Gentlesprite/STBU_Foolish_Potted_Plant/资料/IMG_1619.JPG

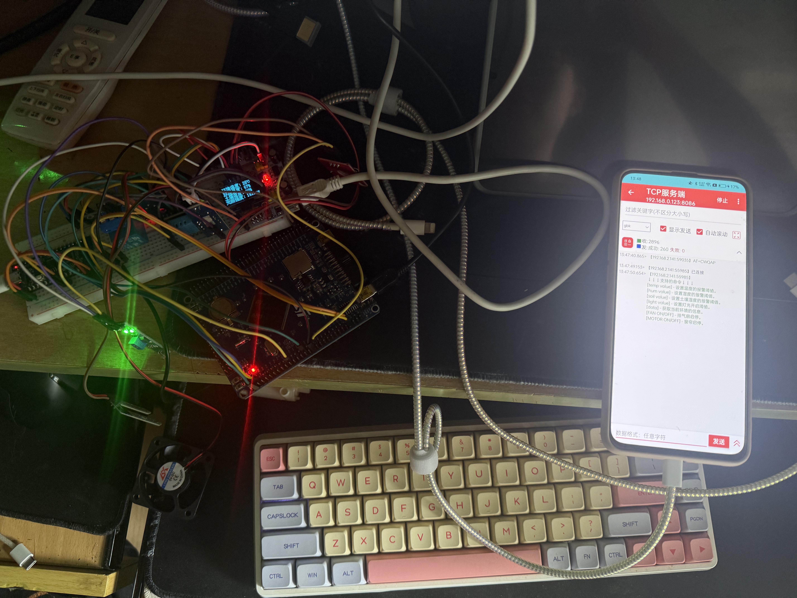
资料/IMG_1619.JPG
