Gentlesprite/STBU_Foolish_Potted_Plant/资料/个人总结.docx

四、总结

4.1 本人负责的工作内容概述

在本项目中，我负责以下模块的设计与实现：HW-080土壤湿度传感器、JY30光照强度传感器、HW-269LED模块、DHT11温湿度传感器驱动，SSD1306显示模块驱动、阈值报警、UART1、UART2、UART3通信。串口通信与命令解析：配置STM32串口3空闲中断，实现不定长数据接收、解析TCP客户端中用户发送的指令，实现阈值设定及设备控制。在论文撰写方面负责：设计任务、设计要求、设计思路及方案的撰写，同时负责硬件原理图、程序流程图的绘制。

4.2 本人负责的关键技术实现

4.2.1 传感器数据采集与处理

(1) JY30光照强度传感器：使用I2C协议通信，获取光照数据, 模拟电压采集，ADC转换。ADC转换参数是12位分辨率（0-4095），55.5个周期采样时间，参考电压3.3V。数据转换公式：电压值 = (ADC值/4096) * 3.3V。计算LDR电阻：R = (电压/(3.3-电压)) * 10kΩ。照度转换：Lux = 40000 * R^(-0.6021)。输出限制：最大值限定为999 Lux。

(2) HW-269LED模块：使用电平触发方式，在环境光照过低时，用于补光功能。GPIO直接驱动，推挽输出控制。高电平触发，初始化使能APB2总线GPIOB时钟，初始化后拉低PB1让灯光熄灭。

(3) DHT11温湿度传感器：使用单总线协议通信，严格时序控制（微秒级延时）数据校验机制：校验和=湿度高8位+湿度低+温度高8位+温度低8位。

4.2.2 OLED显示模块

使用I2C协议通信，SDA：数据线（双向开漏，需上拉电阻），SCL：时钟线（单向，需上拉电阻），起始条件：SCL高电平时，SDA由高→低跳变。数据传输：每1bit在SCL上升沿被采样，下降沿切换SDA。地址帧：7位设备地址（0x78或0x7A）+ 读写位（0=写，1=读）。停止条件：SCL高电平时，SDA由低→高跳变。驱动OLED将温湿度、土壤湿度、光照强度实时显示。

4.2.3 串口通信与命令解析

(1) 串口空闲中断配置

初始化USART3（PB10/PB11），开启空闲中断（IDLE）接收不定长数据，避免固定长度缓冲区的限制，空闲中断实现命令解析与执行。设计的命令如下表：

命令 | 意义
temp value | 设置环境温度的报警阈值
hum value | 设置环境湿度的报警阈值
soil value | 设置土壤湿度的报警阈值
light value | 设置灯光开启阈值
data | 获取当前环境的信息
FAN ON/OFF | 排气扇启停
MOTOR ON/OFF | 水泵启停
LED ON/OFF | LED启停
未知命令的处理 | 发送支持的命令提示

## 表4 项目支持的命令表

4.3 遇到的问题及解决方案

4.3.1 问题1

问题：使用STM32通过AT指令配置ESP32为STA模式，连接手机TCP服务器后，调用esp_32c3_send_data函数向APP发送数据时，数据被错误发送到串口1而非预期的串口3。

原因：ESP32 状态混乱：ESP32 可能处于某种异常状态（如未正确退出透传模式、TCP 连接未正常关闭），导致后续数据发送混乱。串口缓冲区未清空：如果 USART1 和 USART3 的缓冲区未正确清理，可能导致数据被错误地发送到错误的串口。AT 指令执行顺序问题：某些 AT 指令（如 AT+CIPMODE 透传模式）可能会影响 ESP32 的数据流控制，导致串口数据异常。

解决：在主函数调用esp32初始化后调用esp_32c3_send_cmd("AT+CWQAP","OK",200);先主动断开与手机热点的连接，然后再正常连接WiFi，退出透传再进入透传即可解决该问题。

4.3.2 问题2

问题：APP发送命令STM32只能收到一个字符。

原因：串口中断一次只能接受一个字符，导致发送一串字符时命令无法解析。

解决：在初始化中断3时启用空闲中断(USART_IT_IDLE)。

4.3 总结与收获

通过本次项目，我深入掌握了多传感器数据采集与处理：ADC、UART、单总线协议的应用、空闲中断的实际应用场景、开发了基于串口的用户命令解析系统，支持多种控制指令。熟练嵌入式系统人机交互：OLED显示驱动并且通过取模软件自制字库显示汉字。通信协议设计：学会了使用空闲中断来接收一段字符与串口命令解析，实现发送命令的方式配合ESP32C3远程控制设备。调试与优化能力：在本项目中本人采用Git版本控制工具进行清晰有条的版本控制。这次项目不仅巩固了我的嵌入式开发技能，更让我深刻体会到了无线通信技术在智能、自动化管理等领域中的不可或缺地位。同时培养了我解决复杂工程问题的能力，通过团队分工交流合作不断迭代，经历了完整的开发迭代流程，从设计任务要求到功能优化，调试代码，不断解决制作过程中所遇到的各种问题，在完成了课程设计的同时也积累了宝贵的项目经验。

改进方向：可引入更高效的数据压缩算法，减少WiFi传输数据量。增加本地存储功能（EEPROM），保存并记忆用户设定的阈值。
