Gentlesprite/STBU_Foolish_Potted_Plant/资料/LED模块.png

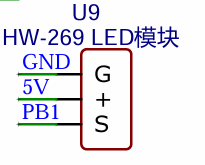
资料/LED模块.png
