Gentlesprite/STBU_Foolish_Potted_Plant/资料/WIFI模块.png

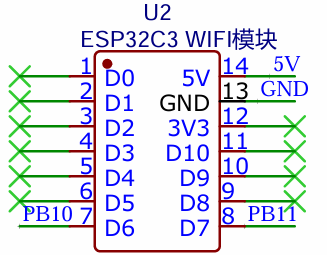
资料/WIFI模块.png
