Gentlesprite/STBU_Foolish_Potted_Plant/资料/光照模块.png

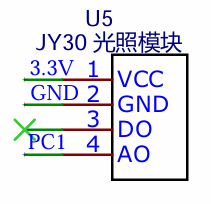
资料/光照模块.png
