Gentlesprite/STBU_Foolish_Potted_Plant/资料/命令表.png

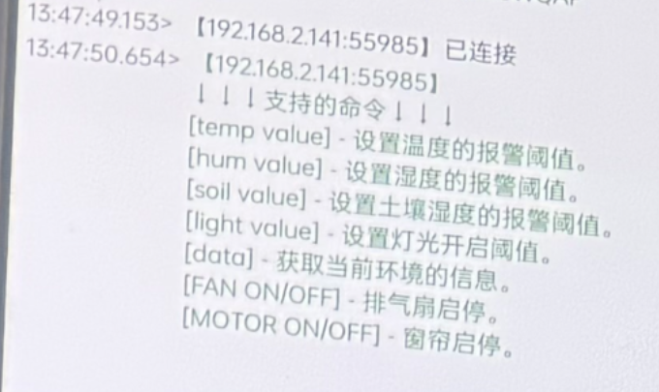
资料/命令表.png
