Gentlesprite/STBU_Foolish_Potted_Plant/资料/土壤湿度模块.png

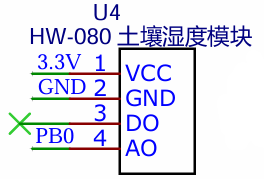
资料/土壤湿度模块.png
