Gentlesprite/STBU_Foolish_Potted_Plant/资料/显示模块.png

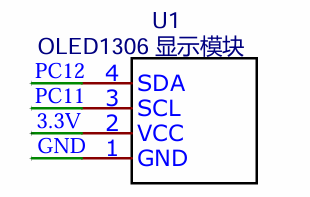
资料/显示模块.png
