Gentlesprite/STBU_Foolish_Potted_Plant/资料/水泵模块.png

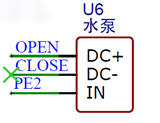
资料/水泵模块.png
