Gentlesprite/STBU_Foolish_Potted_Plant/资料/蜂鸣器模块.png

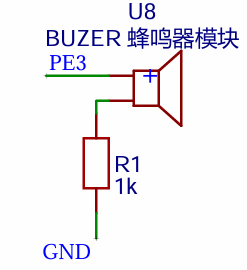
资料/蜂鸣器模块.png
