Gentlesprite/STBU_Foolish_Potted_Plant/资料/风扇模块.png

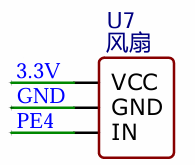
资料/风扇模块.png
