Gentlesprite/STBU_Foolish_Potted_Plant/资料/整机原理图.pdf

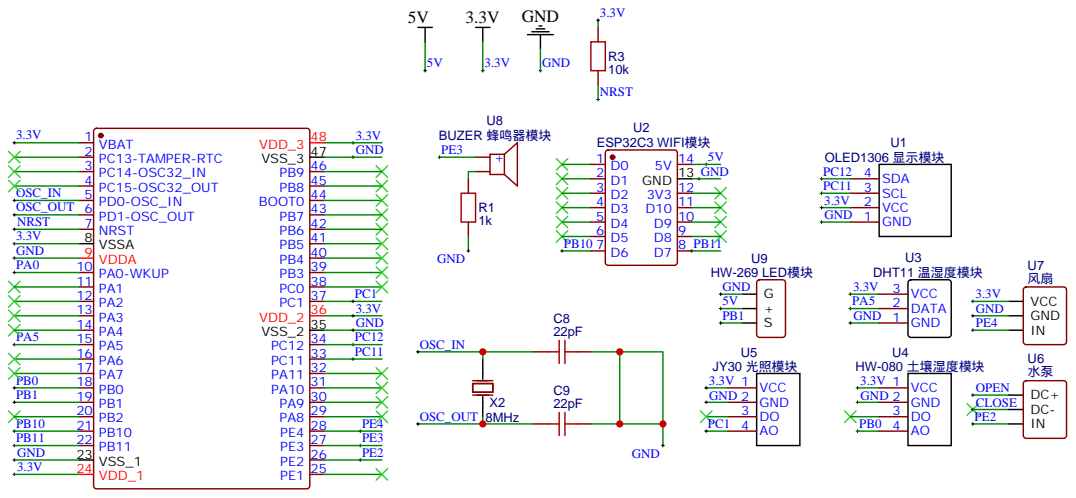
[picture p63: page 1]
