Gentlesprite/STBU_Foolish_Potted_Plant/Hardware/codetab.h

/************************************************************************************
* Description:
* 1. 128*64点整OLED模块功能演示程序的字表;
* 2. 字表由打包资料中的“取字软件”计算得出;
* 3. 取字方式 -- 共阴、列行式、逆向输出
*
* Others: none;
*
* Function List: none;
*
* History: none;
*
*************************************************************************************/


/***************************16*16的点阵字体取模方式：共阴——列行式——逆向输出*********/
unsigned char F16x16[] =
{
		0x04,0x84,0x84,0xFC,0x84,0x84,0x00,0x04,0x04,0x84,0xE4,0x1C,0x84,0x04,0x04,0x00,
		0x20,0x60,0x20,0x1F,0x10,0x10,0x04,0x02,0x01,0x00,0xFF,0x00,0x00,0x01,0x06,0x00,/*"环",0*/
		0x10,0x10,0xFF,0x10,0x10,0x20,0xA4,0xAC,0xB5,0xA6,0xB4,0xAC,0xA4,0x20,0x20,0x00,
		0x10,0x30,0x1F,0x08,0x88,0x80,0x4F,0x3A,0x0A,0x0A,0x7A,0x8A,0x8F,0x80,0xE0,0x00,/*"境",1*/
		0x10,0x60,0x02,0x8C,0x00,0x00,0xFE,0x92,0x92,0x92,0x92,0x92,0xFE,0x00,0x00,0x00,
		0x04,0x04,0x7E,0x01,0x40,0x7E,0x42,0x42,0x7E,0x42,0x7E,0x42,0x42,0x7E,0x40,0x00,/*"温",2*/
		0x00,0x00,0xFC,0x24,0x24,0x24,0xFC,0x25,0x26,0x24,0xFC,0x24,0x24,0x24,0x04,0x00,
		0x40,0x30,0x8F,0x80,0x84,0x4C,0x55,0x25,0x25,0x25,0x55,0x4C,0x80,0x80,0x80,0x00,/*"度",3*/
		0x04,0x84,0x84,0xFC,0x84,0x84,0x00,0x04,0x04,0x84,0xE4,0x1C,0x84,0x04,0x04,0x00,
		0x20,0x60,0x20,0x1F,0x10,0x10,0x04,0x02,0x01,0x00,0xFF,0x00,0x00,0x01,0x06,0x00,/*"环",4*/
		0x10,0x10,0xFF,0x10,0x10,0x20,0xA4,0xAC,0xB5,0xA6,0xB4,0xAC,0xA4,0x20,0x20,0x00,
		0x10,0x30,0x1F,0x08,0x88,0x80,0x4F,0x3A,0x0A,0x0A,0x7A,0x8A,0x8F,0x80,0xE0,0x00,/*"境",5*/
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
  0x08,0xF8,0x88,0x88,0xE8,0x08,0x10,0x00,0x20,0x3F,0x20,0x20,0x23,0x20,0x18,0x00,//E 37
  0x08,0xF8,0x88,0x88,0xE8,0x08,0x10,0x00,0x20,0x3F,0x20,0x00,0x03,0x00,0x00,0x00,//F 38
  0xC0,0x30,0x08,0x08,0x08,0x38,0x00,0x00,0x07,0x18,0x20,0x20,0x22,0x1E,0x02,0x00,//G 39
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
};
