Gentlesprite/STBU_Foolish_Potted_Plant/Hardware/adcx.h

#ifndef _ADCX_H_
#define _ADCX_H_
#include "stm32f10x.h"                  // Device header

// ADC 编号选择
// 可以是 ADC1/2/3
#define    ADCx                          ADC2
#define    ADC_CLK                       RCC_APB2Periph_ADC2



void ADCx_Init(void);
u16 ADC_GetValue(uint8_t ADC_Channel,uint8_t ADC_SampleTime);

#endif
