Gentlesprite/STBU_Foolish_Potted_Plant/(commit log)

2025-06-17 卢治宇第一次提交。
2025-06-17 把二氧化碳改为光照强度。
2025-06-17 卢治宇完成。
2025-06-18 卢治宇最终完成。
2025-06-23 更改任务书
2025-06-23 更新资料。
2025-06-23 提交版。
2025-06-23 新增提交资料。
2025-06-26 陈前修改最终版。
2025-07-03 更新ppt。
2025-08-24 修复项目没有主工程文件入口问题。
2025-08-24 删除无用文件。
